thrinathpolanki/talking-medicine-label/docs/project-overview.md

# Project Overview

<p align="center">Animated header: project overview</p>
<p align="center">Animated signal flow from NFC tag to PN532, ESP32, DFPlayer Mini, PAM8403 and two speakers</p>

Project banner

The Talking Medicine Label is a small battery-powered device. A tag stuck on a medicine container stores a short code and a language. When the container is held near the reader, the device speaks a prerecorded instruction from its memory card.

```mermaid
flowchart LR
  A["Tag: TML:007, language te"] --> B["Reader"] --> C["ESP32 picks file 02/007.mp3"] --> D["Audio player"] --> E["Speaker"]
```

The device is an **aid**. Recordings must be prepared and checked by a qualified person (pharmacist or doctor). It never replaces prescriptions, pharmacist advice, or the doctor's instructions.

See the root [README](../README.md) for the full report, [how-it-works.md](how-it-works.md) for the byte-level walkthrough and [accessibility-and-usability.md](accessibility-and-usability.md) for the design thinking.
