thrinathpolanki/talking-medicine-label/(commit log)

2026-10-28 Add script to generate animated SVGs for project
    This script generates animated SVGs for various project components, including banners, signal flows, power flows, and NFC interactions. It utilizes SMIL animations to create visual representations of the system's functionality.
2026-10-28 Add script to generate wiring diagram in SVG format
    This script generates a schematic-style wiring diagram in SVG format for a circuit involving various components such as a battery, TP4056, ESP32, and others.
2026-10-28 Add hardware block diagram for power management
2026-10-28 Update battery label in power flow diagram
2026-10-28 Update battery label in wiring diagram
2026-10-28 Update battery description in hardware diagram
2026-10-28 Create assembly guide with step-by-step instructions
    Added detailed assembly instructions and checkpoints for hardware setup.
2026-10-28 Add circuit connections documentation
    Document circuit connections, wiring diagrams, and verification status for components.
2026-10-28 Add limitations and future work documentation
    Document current limitations and proposed future work for the project.
2026-10-28 Create power-management.md with detailed guidelines
    Added comprehensive documentation on power management and charging, including wiring instructions, boost converter adjustment, voltage measurements, current budget estimates, and battery checks.
2026-10-28 Create safety guidelines document
    Added safety guidelines for medical and electrical precautions related to device usage.
2026-10-28 Add configuration file for hardware settings
    This file contains configuration settings for the hardware and behavior of the taking medicine label project, including pin assignments for various components and audio layout.
2026-10-28 Create README for talking medicine label firmware
    Added detailed README for talking medicine label firmware, including setup instructions, status, tag format, and button configurations.
2026-10-28 Add Talking Medicine Label firmware
    Initial implementation of the Talking Medicine Label firmware for ESP32 with NFC and audio playback functionality.
2026-10-28 Add animated circuit connections header SVG
    This SVG file contains an animated header for circuit connections, verified against the author's reference diagram.
2026-10-28 Add assembly guide header animation SVG
    Added an SVG file for the assembly guide header animation, featuring twelve stages with animated checkpoints.
2026-10-28 Add signal flow animation SVG
    Added SVG animation illustrating signal flow from NFC tag through various components to speakers.
2026-10-28 Add power flow animation SVG
    Added SVG animation illustrating the power flow in a circuit, including components like USB-C, TP4056, MT3608, ESP32, DFPlayer, PAM8403, and LEDs.
2026-10-28 Add audio path animation SVG
    This SVG file illustrates the audio path from microSD through various components to the speakers, including animations for audio flow.
2026-10-29 Added the wiring diagram
2026-10-29 Enhance wiring diagram with new labels and connections
    Added additional labels and connections for VCC, SDA, SCL, and GPIO pins in the wiring diagram.
2026-10-29 Added esp32-nodemcu-30-pin.png
2026-10-29 Added led-blue-rectangular.png
2026-10-29 Added perfboard-prototype-pcb.png
2026-10-30 Added push-button-tactile-6mm.png
2026-10-30 Added resistor-carbon-film.png
2026-10-30 Added slide-switch-spdt.png
2026-10-30 Added speaker-8ohm-0.5w.png
2026-10-30 Added tp4056-type-c-charger.png
2026-10-30 Update I2C label to include IRQ
2026-10-30 Add IRQ and RSTO pins to PN532 wiring diagram
2026-10-30 Update I2C and GPIO connections in architecture diagram
2026-10-30 Clarify ESP32 and PN532 wiring instructions
    Updated ESP32 and PN532 connection details to include GPIO4 and GPIO5 for IRQ and RSTO.
2026-10-30 Document PN532 connections and update wiring info
    Added PN532 IRQ and RSTO connections with details.
2026-10-30 Revise hardware components documentation
    Updated the hardware components list with new entries and specifications, including LEDs and NFC tag.
2026-11-01 Modify PN532 pin configurations in config.example.h
    Updated PN532 IRQ and RSTO pin definitions for ESP32.
2026-11-01 Revise GPIO pin usage and PN532 connections
    Updated GPIO pin assignments and added details about PN532 wiring.
2026-11-01 Enhance PN532 initialization and error handling
    Updated PN532 error message and added monitoring for PN532 reset-output line.
    [talking-medicine-label.ino]
2026-11-01 Update audio-chain.svg for animation details
2026-11-01 Update power flow SVG animation
2026-11-01 Enhance signal flow animation with I2C and IRQ details
    Updated the signal flow animation SVG to include additional details for the I2C and IRQ connections.
2026-11-01 Update SVG animation for assembly guide header
2026-11-01 Update SVG animation for circuit connections
2026-11-03 Update print statement from 'Hello' to 'Goodbye'
2026-11-03 Implement animated wiring diagram generation
    Added animated overlay version for wiring diagram generation, including flow and pulse effects.
2026-11-03 Revise assembly guide for accessibility and usability
    Updated the assembly guide to focus on accessibility and usability, including new images and principles for user interaction. Added recording structure and prompts for user guidance.
2026-11-03 Revise assembly guide with new structure and flowchart
    Updated the assembly guide to focus on assembly stages and added a flowchart. Removed previous accessibility and usability content.
2026-11-03 Add Bill of Materials document
    This document outlines the bill of materials for the project, including part descriptions, quantities, and notes for sourcing and assembly.
2026-11-03 Enhance circuit connections documentation
    Added an animated wiring diagram and updated reference information.
2026-11-03 Create enclosure and layout documentation
    Added detailed guidelines for enclosure and layout, including placement rules and construction notes.
2026-11-03 Add firmware design documentation
    Document firmware design details, including file roles, functions, configuration reference, error handling, LED patterns, and known limitations.
2026-11-03 Update hardware-components.md with additional references
    Added references to bill of materials and pinout documentation for clarity.
2026-11-03 Add documentation for how the system works
    This document explains the sequence of events when a tagged medicine box is tapped, detailing the interactions between hardware components and firmware logic. It also covers what the tag stores, audio player commands, button functionalities, and signal/power chains.
2026-11-03 Add pinout reference documentation
    Added detailed pinout reference for ESP32 NodeMCU, PN532 NFC/RFID, DFPlayer Mini, PAM8403 module, TP4056 Type-C module, and MT3608 boost module.
2026-11-03 Update power-management.md with new sections
    Added sections on the charging cycle and output voltage settings, along with voltage measurements and power budget animations.
2026-11-03 Enhance troubleshooting documentation with images and details
    Added an animated troubleshooting flow image and expanded the troubleshooting table with symptoms, likely causes, and diagnostic steps.
2026-11-04 Add assembly stages animation SVG
    This SVG file contains an animation illustrating twelve assembly stages with corresponding checkpoints and a progress bar.
2026-11-04 Add buttons demo animation SVG
    This SVG file contains an animation demo for buttons that illustrate volume control and language selection.
2026-11-04 Add charging cycle animation SVG
    This SVG illustrates the charging cycle of a battery, detailing phases such as pre-charge, constant current, and charge complete, along with corresponding animations and visual elements.
2026-11-04 Add DFPlayer command frame SVG animation
    Added an SVG file for DFPlayer command frame with detailed byte-by-byte explanations for commands and parameters.
2026-11-04 Add enclosure layout animation SVG
    This SVG file contains an animation of the enclosure layout, including views and interactive elements such as speakers, buttons, and indicators.
2026-11-04 Add MT3608 adjustment animation SVG
    This SVG file contains an animation illustrating the adjustment of the MT3608 voltage regulator from 3.70 V to 5.00 V, including visual elements and text descriptions.
2026-11-04 Add animated power budget SVG
    This SVG file contains an animated bar chart representing the power budget for various components, including estimated current for each load and total current on the rail and cell side.
2026-11-04 Add sequence diagram animation for NFC interaction
    This SVG file contains a sequence diagram animation illustrating the interaction between an NFC tag, PN532, ESP32, DFPlayer Mini, and an amplifier with speakers. It includes various messages and timings related to the NFC communication process.
2026-11-04 Add signal flow animation SVG
    This SVG file represents an animated signal flow diagram illustrating the connection from an NFC tag through various components to speakers.
2026-11-04 Revise SVG animation for signal flow representation
    Updated SVG animation to include signal flow from NFC tag to speakers, enhancing visual representation of the system.
2026-11-04 Enhance strip-assembly.svg with animations
    Updated SVG file with new animations and descriptions for assembly guide.
2026-11-04 Add animated bill of materials header SVG
    This SVG file contains an animated header for the bill of materials, including decorative elements and text.
2026-11-04 Update SVG animation for circuit connections header
2026-11-04 Add animated enclosure layout SVG
    This SVG file contains an animated header for enclosure and layout, featuring decorative elements and text.
2026-11-04 Add troubleshooting flow animation SVG
    This SVG file contains a troubleshooting flow animation with a series of questions and checks related to audio functionality.
2026-11-04 Add firmware design header animation SVG
    Added an SVG file for firmware design header animation with configuration, states, errors, and LED patterns.
2026-11-04 Add animated pin reference header SVG
    This SVG file contains an animated header for pin reference, showcasing every module pin and ESP32 GPIO in use.
2026-11-05 Add medicine register template CSV file
    [medicine-register-template.csv]
2026-11-05 Update hardware validation checklist with case list reference
    Added reference to full case list in test-plan.md for clarity.
2026-11-05 Create detailed test plan with 35 test cases
    Added a comprehensive test plan with 35 test cases covering power, NFC, audio, buttons, and robustness. Each test case includes ID, area, test description, steps, expected results, and current results.
