thrinathpolanki/talking-medicine-label/(notices)

Notices in the files:
README.md:
License: MIT
